tulp-foundation/v100-sxm2-fan-shroud/step/full_assembly.step

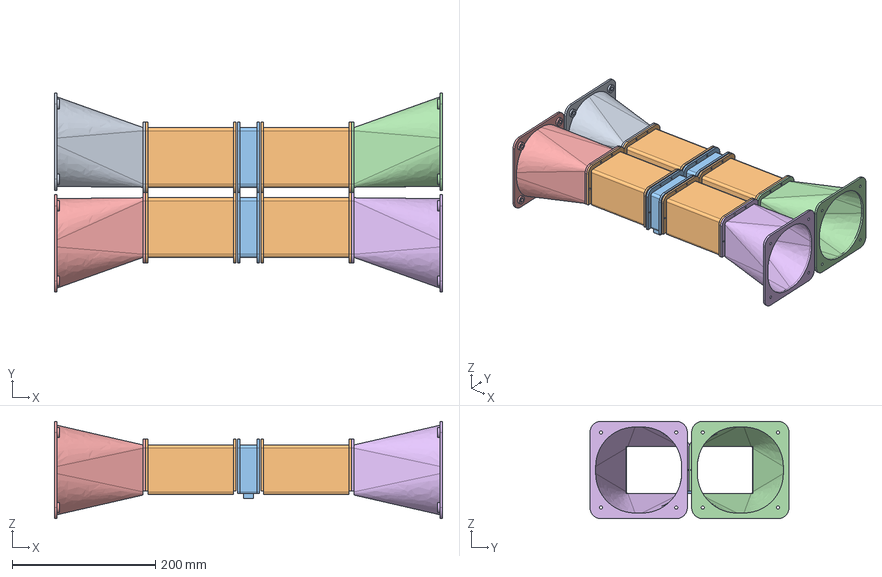
[picture p1: CAD file, 2026-10-22]
step/full_assembly.step
541.7 x 278.0 x 136.0 mm
