tulp-foundation/v100-sxm2-fan-shroud/step/part4_exhaust_shroud_top.step

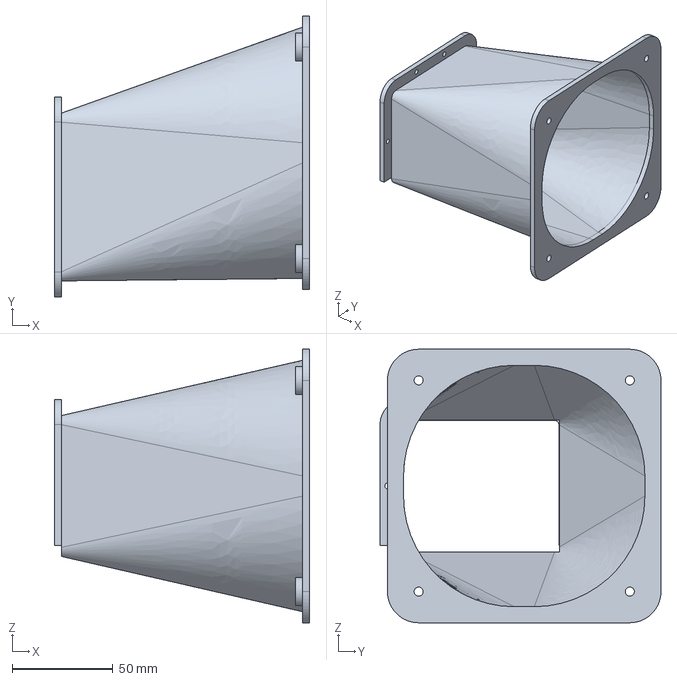
[picture p2: CAD file, 2026-10-22]
step/part4_exhaust_shroud_top.step
127.0 x 139.7 x 136.0 mm
