tulp-foundation/v100-sxm2-fan-shroud/step/part2_hs_enclosure.step

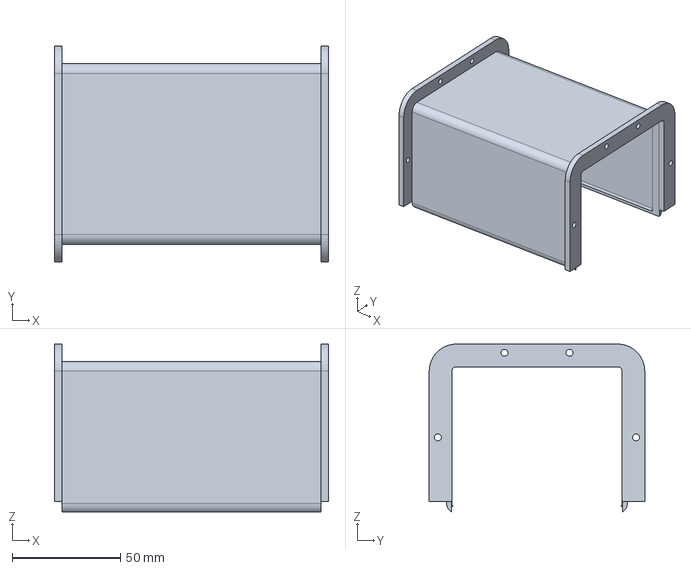
[picture p3: CAD file, 2026-10-22]
step/part2_hs_enclosure.step
126.3 x 99.4 x 77.4 mm
