tulp-foundation/v100-sxm2-fan-shroud/step/part3_gap_bridge.step

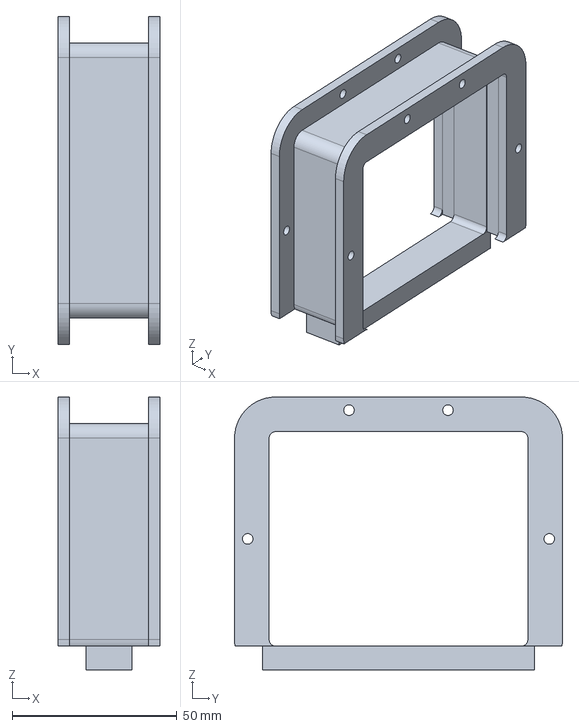
[picture p4: CAD file, 2026-10-22]
step/part3_gap_bridge.step
30.9 x 99.4 x 82.7 mm
