tulp-foundation/v100-sxm2-fan-shroud/(list of files, cad)

Other CAD files:
step/part1_intake_taper_bottom.step
step/part1_intake_taper_top.step
step/part4_exhaust_shroud_bottom.step
stl/part1_intake_taper_bottom.stl
stl/part1_intake_taper_top.stl
stl/part2_hs_enclosure.stl
stl/part3_gap_bridge.stl
stl/part4_exhaust_shroud_bottom.stl
stl/part4_exhaust_shroud_top.stl
